shaduzlabs/pink-0/README.md

# pink-0
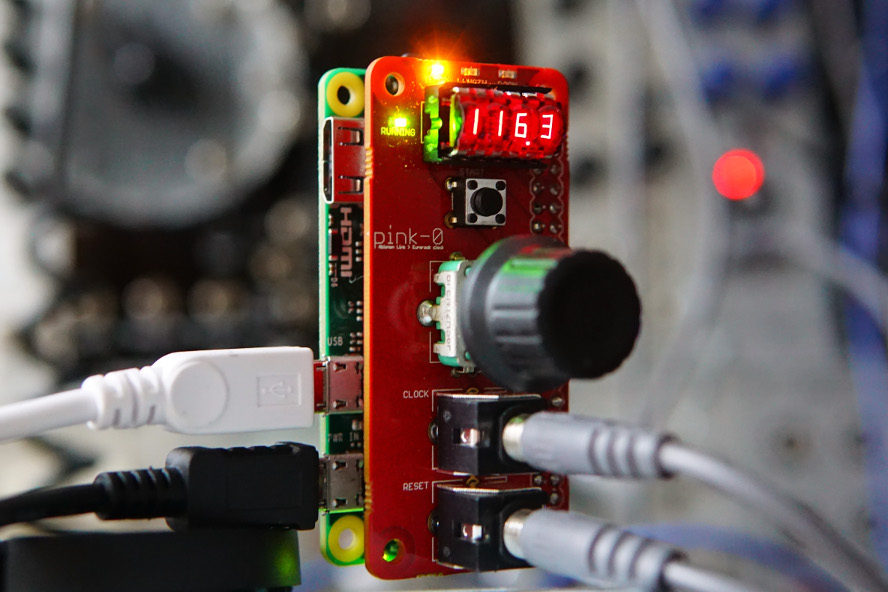
[picture p1: hardware/pink-0.jpg]
A rendering of the Arduino shield


This repository contains the source code and the schematics for an Ableton Link to clock/reset converter.
