shaduzlabs/pink-0/(threads)

Thread 1 (2017-03-03):

Parts list?

Skeyelab, 2017-03-03:
So I just ordered 6 PCBs from batchpcb.com. I have experience w through hole components, but not surface mount and I'm not exactly sure how to order the resistors and capacitors. Everything else, I'm pretty comfy with.

Can you provide some info on this?

Thanks
Eric (from the Discourse thread)

shaduzlabs, 2017-03-07:
see hardware/BOM.txt
more documentation will follow

Closed 2017-03-07.

Thread 4 (2017-03-27):

pinkd silently exits, every time

ectal, 2017-03-27:
I've pulled the repo, successfully run the install script, the access point shows up after reboot, everything looks fine, but the demon is never actually running.

If I attempt to start the service:

```
 pink.service - LSB: piNK daemon
   Loaded: loaded (/etc/init.d/pink)
   Active: active (exited) since Mon 2017-03-27 14:11:33 UTC; 54s ago
  Process: 406 ExecStart=/etc/init.d/pink start (code=exited, status=0/SUCCESS)

Mar 27 14:11:33 raspberrypi pink[406]: pinkd: daemon starting
Mar 27 14:11:33 raspberrypi pinkd[412]: daemon starting
Mar 27 14:11:33 raspberrypi systemd[1]: Started LSB: piNK daemon.
```

Then check its status:

```
 pink.service - LSB: piNK daemon
   Loaded: loaded (/etc/init.d/pink)
   Active: active (exited) since Mon 2017-03-27 14:11:33 UTC; 1min 31s ago
  Process: 406 ExecStart=/etc/init.d/pink start (code=exited, status=0/SUCCESS)

Mar 27 14:11:33 raspberrypi pink[406]: pinkd: daemon starting
Mar 27 14:11:33 raspberrypi pinkd[412]: daemon starting
Mar 27 14:11:33 raspberrypi systemd[1]: Started LSB: piNK daemon.
```

Definitely no pinkd process running if I check with ps afterward.

Even with it not running, I still see a lock file:

```
pi@raspberrypi:~ $ ls /var/run/lock/subsys/
pinkd
```

The only "interesting" logging I've been able to find anywhere is in /var/log/daemon.log showing that a restart gets an error because the process isn't found:

```
Mar 27 14:15:33 raspberrypi pink[1084]: pinkd: no process found
Mar 27 14:15:33 raspberrypi systemd[1]: pink.service: control process exited, code=exited status=1
```

Any thoughts? Problem with the hat, maybe? Any unusual place any logging or output might be hiding?

additional info:

* uname -a: Linux raspberrypi 4.4.50+ #970
* Downloaded jessie w/ pixel from: https://www.raspberrypi.org/downloads/raspbian/
* created boot sd using the Mac program Etcher
* Tried the install both before and after an apt-get upgrade

hdavid, 2017-03-27:
i am having the same problem, which seems to be linked to portaudio not finding the default audio ouput. Vincenzo advised me to "check out the develop branch and start the executable manually with the argument "no-daemon", you should see the error 'Could not get audio device'". which i did, confirming the problem.

going to explore tonight, starting with this.
https://app.assembla.com/wiki/show/portaudio/Platforms_RaspberryPi

the strange part is that i got it work, on a dirty raspberry pi installation before doing "clean install" like you did. so it must be smth linked to libary version, or alsa settings or smth of this sort. i wonder if it would not just work by installing portaudio as a debian package.

ectal, 2017-03-27:
As far as I can tell, portaudio just wasn't ever installed successfully. Didn't notice any errors when running install.sh. /shrug

I managed to get things working by just downloading portaudio from here:

http://www.portaudio.com/download.html

Just unpacked, did configure, make, sudo make install, and now pinkd gladly runs.

Cheers!

hdavid, 2017-03-27:
confirmed to work ! thanks for the hint :)
cpu is quite high though on my raspberry pi 3 b. (100% on one core)

shaduzlabs, 2017-03-27:
@ectal thanks indeed for sharing your solution!
Most likely this is due to libsnd2 not being installed when the installer script builds portaudio. I will investigate further and improve the script.

@hdavid wow didn't really pay attention to cpu usage lately! Turned out to be an issue in [nmws](https://github.com/shaduzlabs/nmws), the nanomsg wrapper that provides the web socket connectivity. It should now be fixed on `develop`, but you'll need to update the submodules.
CPU usage on my pi3 is now <4%.

ectal, 2017-03-28:
@shaduzlabs No problem. And yeah, just installing libasound-dev before running install seems to do the trick, as I discovered after managing to physically destroy an SD card and needing to start over. :)

Closed 2017-04-26.

Thread 5 (2017-03-29):

Feature Request: Shutdown Shortcut

ectal, 2017-03-29:
Any chance you could add a shutdown command, maybe with a long press of the encoder (5 seconds or so)?

Thread 7 (2017-04-21):

Feature Request: MIDI Clock out

Skeyelab, 2017-04-21:
I think this thing is awesome.  I got boards made, I've yet to build one, as the components are extremely small (as you know) and i dont think I will be able to do it by hand.

However, I am thinking of making one in a box.  It would be very useful to me if it had midi out as well.  I have some MIDI gear that would benefit greatly by pulling it off of a single master midi clock with its own Link controller - hardwired via ethernet - it would be awesome.

I really think that would make this product a real game changer.

paulmallon, 2017-04-21:
Hey

I can recommend a stand alon usb board made by Lauri Koponen. I have used
it in several rpi projects and it is super reliable and well made.

Here is a link with specs

http://rpc.gehennom.org/2015/06/second-iteration-usbmidi2/

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

--

*Paul Mallon*

Developer

Digital 1:1 communication reinvented

Compost Marketing AB

Drottninggatan 55, 111 21 STOCKHOLM

Switchboard +46 8-505 721 00 | Direct +46 7 331 523 04

Get in touch www.compost.se | paul@compost.se

Thread 8 (2017-04-25):

HP QDSP 6064 Bubble Display Not Available Anymore

cereyanli, 2017-04-25:
Hello

HP QDSP 6064 Bubble Display that you used in the project is not available anymore.

Can you recommend a replacement ? or do you have any plans to update the PCB design for more accessible display ?

Thanks

shaduzlabs, 2017-04-25:
Hi, yes I'm currently evaluating some options for a new hardware version which will most likely use a graphic OLED display

Skeyelab, 2017-04-25:
Shouldn't most any 7 segment display work?

Thread 9 (2018-01-07):

No Ouput for Clock

Gruftgrabbler, 2018-01-07:
Hello Shaduzlabs Team,

I am using a Raspberry Pi 3 and have connected all GPIO Pins on a Breadboard exactly the way shown in the schematics pdf.

Unfortunately I cant get an output for the Link clock, even  the connection to Ableton link was successful.
I have a Broadboard-Protoype with the 4 LEDs and thought the second LED would blink with the Ableton beat.

Also I have not connected a Display or a rotary Encoder.

Dou you have any ideas how to fix our problem?

I would like to develop the project with some more I/O functionality.

Best regards Gruftgrabbler

hdavid, 2018-01-10:
check that you are using pwm output for audio, and not the jack outputs (easily checkable by plugging some headphone on the jack audio out).
i remember i had to fix one or the other thing to make is use the pwm output on rpi 3, but i am unsure what.

Gruftgrabbler, 2018-01-31:
Okay thank you. Yes I make a big mistake thinking that the "Tempo" Led will blink in the same tempo as the Link Connection. Dont thought about a menu or something like that :)

Thread 10 (2018-01-22):

Missing bom item

beliefsystemrecords, 2018-01-22:
1k resistor missing in bom

shaduzlabs, 2018-01-23:
fixed! thanks :)
