shaduzlabs/pink-0/hardware/pink-0.pdf

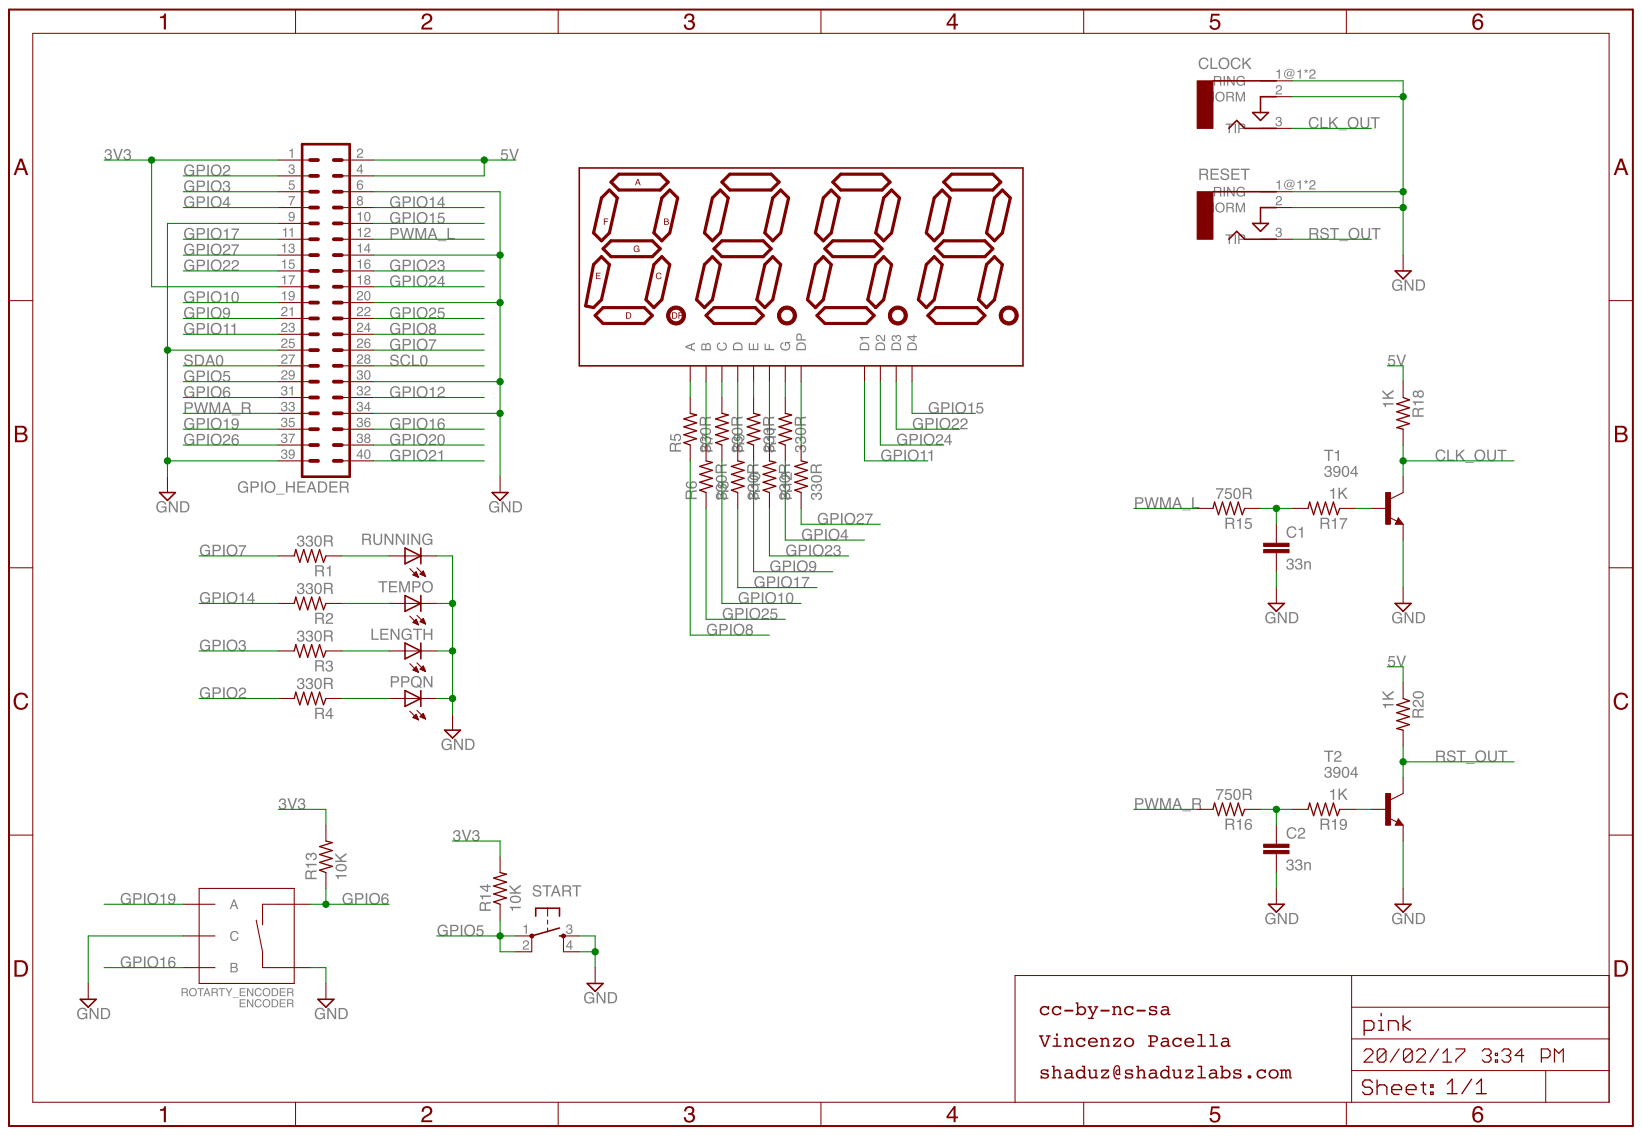
[picture p2: page 1]
