shaduzlabs/pink-0/hardware/pink-0.brd

## EAGLE design hardware/pink-0.brd (2017-02-21)

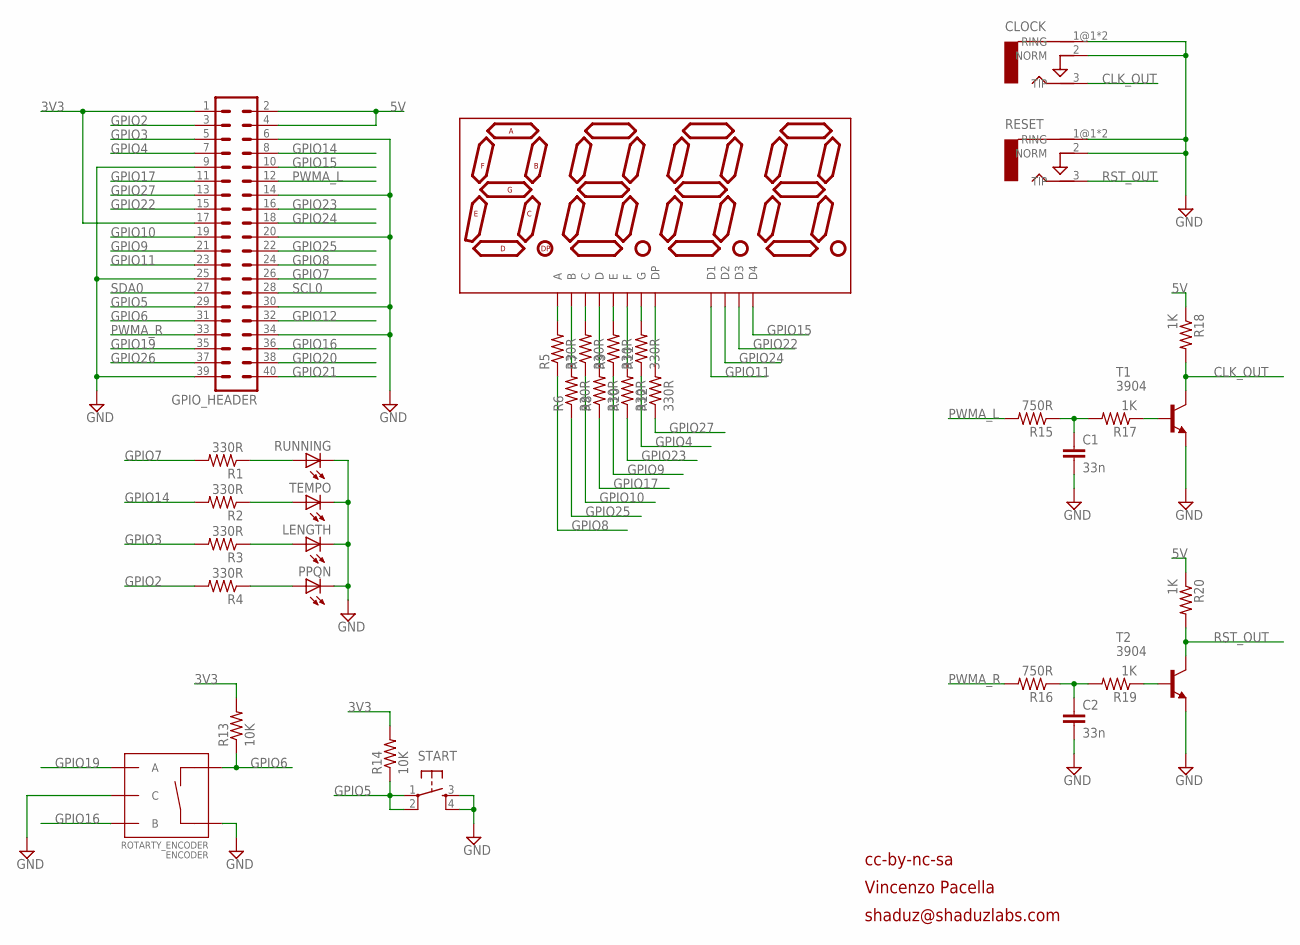
[picture p3: schematic pink-0.sch]

Parts:
C1, C2: 33n; 0603-CAP
CLOCK: AUDIO-JACKERTHENVAR; ERTHENVAR-JACK
DISP1: QDSP6064; DIL12
ENCODER: ROTARTY_ENCODER; ROTARY_ENC_PLAIN
GPIO_HEADER: PIZERO_THROUGH_HOLE; PIZERO_THOUGH_HOLE
LENGTH: LED0603; LED-0603
PPQN: LED0603; LED-0603
R1, R2, R3, R4, R5, R6, R7, R8, R9, R10, R11, R12: 330R; R0402
R13, R14: 10K; R0402
R15, R16: 750R; R0402
R17, R18, R19, R20: 1K; R0402
RESET: AUDIO-JACKERTHENVAR; ERTHENVAR-JACK
RUNNING: LED0603; LED-0603
START: TAC_SWITCHPTH; TACTILE-PTH
T1, T2: 3904; SOT23-BEC
TEMPO: LED0603; LED-0603

Connections:
3V3: GPIO_HEADER.1, GPIO_HEADER.17, R13.2, R14.2
5V: GPIO_HEADER.2, GPIO_HEADER.4, R18.1, R20.1
CLK_OUT: CLOCK.3 (TIP), R18.2, T1.C
GND: C1.2, C2.2, CLOCK.1@1 (RING), CLOCK.1@2 (RING), CLOCK.2 (NORM), ENCODER.C, ENCODER.SW+, GPIO_HEADER.6, GPIO_HEADER.9, GPIO_HEADER.14, GPIO_HEADER.20, GPIO_HEADER.25, GPIO_HEADER.30, GPIO_HEADER.34, GPIO_HEADER.39, LENGTH.C, PPQN.C, RESET.1@1 (RING), RESET.1@2 (RING), RESET.2 (NORM), RUNNING.C, START.3, START.4, T1.E, T2.E, TEMPO.C
GPIO2: GPIO_HEADER.3, R4.2
GPIO3: GPIO_HEADER.5, R3.2
GPIO4: GPIO_HEADER.7, R11.1
GPIO5: GPIO_HEADER.29, R14.1, START.1, START.2
GPIO6: ENCODER.SW-, GPIO_HEADER.31, R13.1
GPIO7: GPIO_HEADER.26, R1.2
GPIO8: GPIO_HEADER.24, R5.1
GPIO9: GPIO_HEADER.21, R9.1
GPIO10: GPIO_HEADER.19, R7.1
GPIO11: DISP1.1 (D1), GPIO_HEADER.23
GPIO12: GPIO_HEADER.32
GPIO14: GPIO_HEADER.8, R2.2
GPIO15: DISP1.6 (D4), GPIO_HEADER.10
GPIO16: ENCODER.B, GPIO_HEADER.36
GPIO17: GPIO_HEADER.11, R8.1
GPIO19: ENCODER.A, GPIO_HEADER.35
GPIO20: GPIO_HEADER.38
GPIO21: GPIO_HEADER.40
GPIO22: DISP1.4 (D3), GPIO_HEADER.15
GPIO23: GPIO_HEADER.16, R10.1
GPIO24: DISP1.10 (D2), GPIO_HEADER.18
GPIO25: GPIO_HEADER.22, R6.1
GPIO26: GPIO_HEADER.37
GPIO27: GPIO_HEADER.13, R12.1
unnamed: DISP1.12 (A), R5.2
unnamed: DISP1.11 (B), R6.2
unnamed: DISP1.3 (C), R7.2
unnamed: DISP1.8 (D), R8.2
unnamed: R1.1, RUNNING.A
unnamed: R2.1, TEMPO.A
unnamed: DISP1.2 (E), R9.2
unnamed: DISP1.9 (F), R10.2
unnamed: DISP1.7 (G), R11.2
unnamed: DISP1.5 (DP), R12.2
unnamed: R19.1, T2.B
unnamed: R17.1, T1.B
unnamed: C1.1, R15.1, R17.2
unnamed: LENGTH.A, R3.1
unnamed: PPQN.A, R4.1
unnamed: C2.1, R16.1, R19.2
PWMA_L: GPIO_HEADER.12, R15.2
PWMA_R: GPIO_HEADER.33, R16.2
RST_OUT: R20.2, RESET.3 (TIP), T2.C
SCL0: GPIO_HEADER.28
SDA0: GPIO_HEADER.27

Notes on the sheet:
cc-by-nc-sa
Vincenzo Pacella
shaduz@shaduzlabs.com

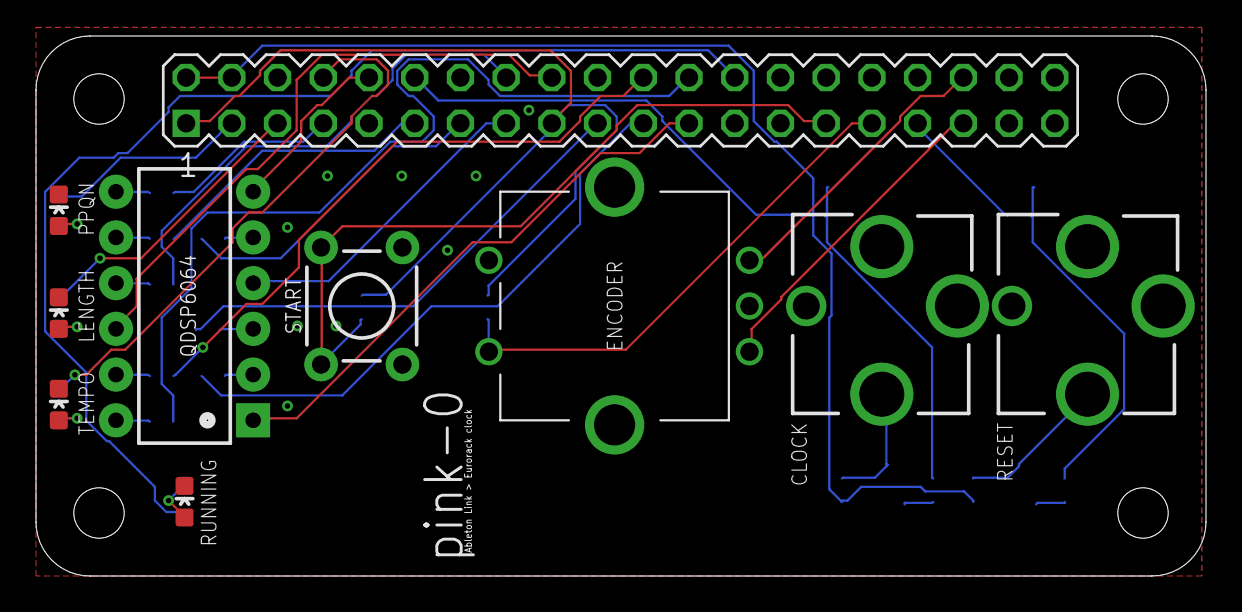
[picture p4: board pink-0.brd from above]

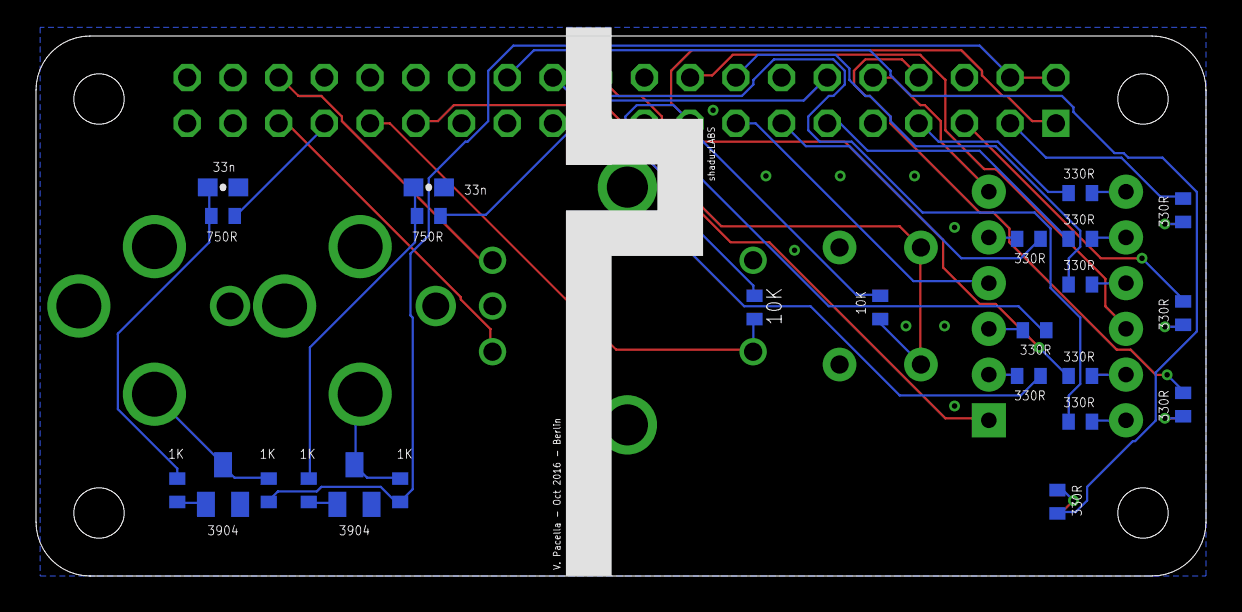
[picture p5: board pink-0.brd from below]

Board: 2 copper layers, 65.0 x 30.0 mm, 34 parts (24 on the bottom side), 43 nets.
