shaduzlabs/pink-0/(commit log)

2017-02-21 first import from private repo
    [config.txt, pink-0.brd, pink-0.sch]
2017-02-24 add UserInterfaceNone
    [config.txt]
2017-03-07 add pink-0 BOM
2017-03-13 update install script, fix websocket binding
    [UserInterfaceWebSocket.cpp]
2017-04-06 fix default audio buffer value
    [Engine.cpp]
